ruralguru/ClockRadio_6x18SegDisp_I2C/Documents/Block_Diagram/ClockRadio_6x18SegDisp_I2C_Block_Diagram.pdf

# Clock Radio Display Board

# Block Diagram

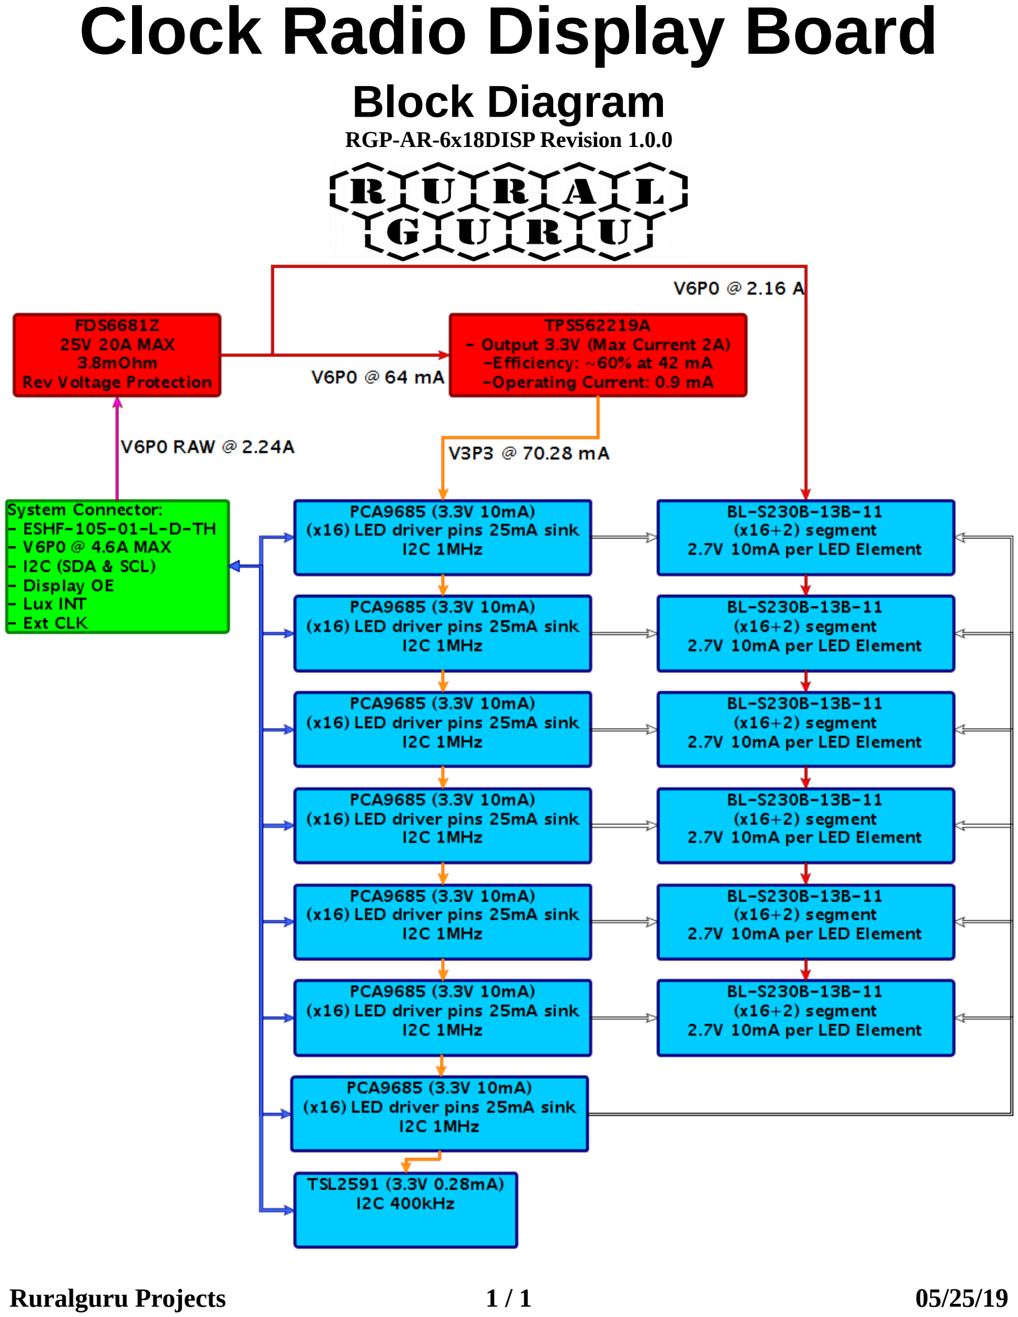
[picture p1: page 1]

RGP-AR-6x18DISP Revision 1.0.0

Ruralguru Projects | 1 / 1 | 05/25/19
