ruralguru/ClockRadio_6x18SegDisp_I2C/Documents/Block_Diagram/ClockRadio_6x18SegDisp_I2C_Block_Diagram.jpg

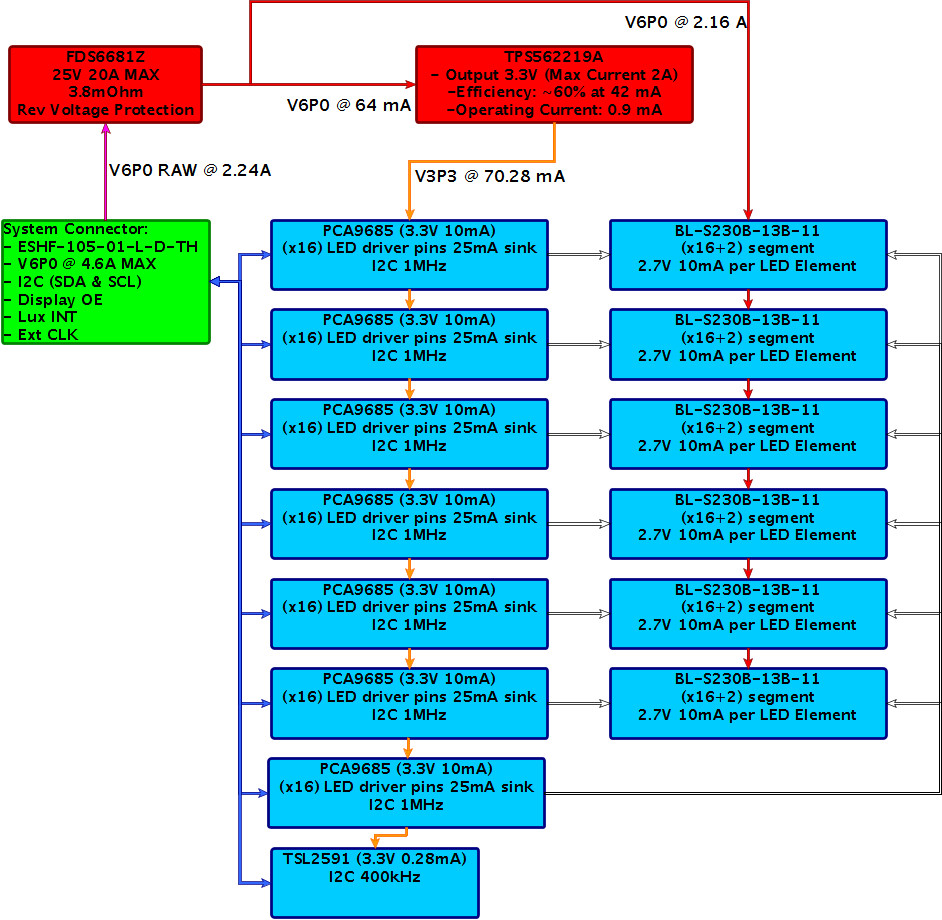
Documents/Block_Diagram/ClockRadio_6x18SegDisp_I2C_Block_Diagram.jpg
