ruralguru/ClockRadio_6x18SegDisp_I2C/Documents/BOM/ClockRadio_Populated.ods

ClockRadio_6x18SegDisp_I2C BOM |  |  |  |  | 05/25/19
Reference | Component | Manufacturer | Description | Total | Used | Cost Per | Total
C101 | EEU-FC1V681 | Panasonic | CAP Dielectric Radial 680uF 5mm Pitch (https://www.mouser.com/ProductDetail/Panasonic/EEU-FC1V681) | 1 | 1 | $0.790 | $0.79
C102 C107 | C1608X5R1A226M080AC | TDK | CAP Ceramic 0603 22uF X5R 10V (https://www.mouser.com/ProductDetail/810-C1608X5R1A226M) | 2 | 2 | $0.480 | $0.96
C103 | GRM033R71A822KA01D | muRata | CAP Ceramic 0603 8.2nF X7R 10V (https://www.mouser.com/ProductDetail/81-GRM033R71A822KA1D) | 1 | 1 | $0.100 | $0.10
C104 C105 C202 C302 C402 C502 C602 C702 C802 | GCM188R91E104KA37D | muRata | CAP Ceramic 0603 0.1uF X7R 25V (https://www.mouser.com/ProductDetail/Murata-Electronics/GCM188R91E104KA37D) | 9 | 9 | $0.149 | $1.34
C106 C201 C301 C401 C501 C601 C701 C801 | GCJ188R71E105KA01D | muRata | CAP Ceramic 0603 1uF X7R 25V (https://www.mouser.com/ProductDetail/Murata-Electronics/GCJ188R71E105KA01D) | 8 | 8 | $0.213 | $1.70
C303 C403 C503 C603 C703 C803 | 860080473006 | Wurth Electronics | CAP Dielectric Radial 100uF 2.5mm Pitch (https://www.mouser.com/ProductDetail/710-860080473006) | 6 | 6 | $0.165 | $0.99
D101 D102 | 150060VS55040 | Wurth Electronics | LED 0603 GRN 2V 20mA (https://www.mouser.com/ProductDetail/710-150060VS55040) | 2 | 2 | $0.170 | $0.34
J101 | ESHF-105-01-L-D-TH | Samtec | CONN 2x5 Header Keyed 2.3A per Pin (https://www.mouser.com/ProductDetail/200-ESHF10501LDTH) | 1 | 1 | $2.810 | $2.81
J102 | PJ-102AH | CUI | CONN Barrell Jack 24V 5A (https://www.mouser.com/ProductDetail/490-PJ-102AH) | 1 | 1 | $0.760 | $0.76
J103 | 10129381-906001BLF | Amphenol | CONN 2x3 Header (https://www.mouser.com/ProductDetail/Amphenol-FCI/10129381-906001BLF) | 1 | 1 | $0.270 | $0.27
L101 | SRP5030T-3R3M | Bourns | IND Fixed 5030 3.3uH 5A 38mOhm (https://www.mouser.com/ProductDetail/652-SRP5030T-3R3M) | 1 | 1 | $1.290 | $1.29
Q101 | FDS6681Z | ON | FET Enhanced P 25V 20A 3.8mOhm (https://www.mouser.com/ProductDetail/512-FDS6681Z) | 1 | 1 | $1.800 | $1.80
R102 R103 R201 R202 R203 R204 R205 R206 R208 R209 R210 R211 R212 R213 R302 R303 R304 R305 R306 R308 R309 R310 R311 R312 R313 R402 R403 R404 R405 R406 R408 R409 R410 R411 R412 R413 R502 R503 R504 R505 R506 R508 R509 R510 R511 R512 R513 R602 R603 R604 R605 R606 R608 R609 R610 R611 R612 R613 R702 R703 R704 R705 R706 R708 R709 R710 R711 R712 R713 R802 R803 R804 R805 R806 R808 R809 R810 R811 R812 R813 | RT0603FRE071KL | Yageo | RES Thin Film 0603 1K 1% (https://www.mouser.com/ProductDetail/603-RT0603FRE071KL) | 80 | 41 | $0.015 | $0.62
R105 | RT0603DRE07200RL | Yageo | RES Thin Film 0603 200R 0.5% (https://www.mouser.com/ProductDetail/Yageo/RT0603DRE07200RL) | 1 | 1 | $0.130 | $0.13
R107 | RT0603FRE07100KL | Yageo | RES Thin Film 0603 100K 1% (https://www.mouser.com/ProductDetail/Yageo/RT0603FRE07100KL?qs=sGAEpiMZZMu61qfTUdNhGxEjuuBLd0B4sFR4hIrpyzw%3D) | 1 | 1 | $0.015 | $0.02
R108 | RT0603DRE0733K2L | Yageo | RES Thin Film 0603 33.2K 0.5% (https://www.mouser.com/ProductDetail/Yageo/RT0603DRE0733K2L) | 1 | 1 | $0.110 | $0.11
R101 R104 R109 R207 R307 R407 R507 R607 R707 R807 | RT0603FRE0710KL | Yageo | RES Thin Film 0603 10K 1% (https://www.mouser.com/ProductDetail/Yageo/RT0603FRE0710KL) | 10 | 10 | $0.045 | $0.45
R110 | RT0603FRE07120RL | Yageo | Res Thin Film 0603 120R 1% (https://www.mouser.com/ProductDetail/Yageo/RT0603FRE07120RL?qs=sGAEpiMZZMu61qfTUdNhGxEjuuBLd0B46F4Pwi2emk8%3D) | 1 | 1 | $0.190 | $0.19
R106 R111 R112 R113 R114 R115 R116 R117 R118 R119 R120 R121 R122 R123 R124 R125 R126 R127 R128 R129 R130 R131 | RC0603FR-070RL | Yageo | RES Thin Film 0603 0R (https://www.mouser.com/ProductDetail/Yageo/RC0603FR-070RL?qs=sGAEpiMZZMvdGkrng054t8AJgcdMkx7xZdNoPBh6LNc%3D) | 22 | 14 | $0.005 | $0.07
R314 R315 R316 R317 R318 R319 R320 R321 R323 R328 R414 R415 R416 R417 R418 R419 R420 R421 R423 R428 R514 R515 R516 R517 R518 R519 R520 R521 R523 R528 R614 R615 R616 R617 R618 R619 R620 R621 R623 R628 R714 R715 R716 R717 R718 R719 R720 R721 R723 R728 R814 R815 R816 R817 R818 R819 R820 R821 R823 R828 | RT0603FRE0715RL | Yageo | RES Thin Film 0603 15R 0.5% (https://www.mouser.com/ProductDetail/Yageo/RT0603FRE0715RL?qs=sGAEpiMZZMu61qfTUdNhGxEjuuBLd0B4DTiXGr7nsPU%3D) | 60 | 60 | $0.015 | $0.90
R324 R325 R326 R327 R329 R330 R424 R425 R426 R427 R429 R430 R524 R525 R526 R527 R529 R530 R624 R625 R626 R627 R629 R630 R724 R725 R726 R727 R729 R730 R824 R825 R826 R827 R829 R830 | RT0603FRE0727RL | Yageo | RES Thin Film 0603 27R 1% (https://www.mouser.com/ProductDetail/603-RT0603FRE0727RL) | 36 | 36 | $0.046 | $1.66
R322 R331 R422 R431 R522 R531 R622 R631 R722 R731 R822 R831 | RT0603DRE07150RL | Yageo | RES Thin Film 0603 150R 0.5% (https://www.mouser.com/ProductDetail/Yageo/RT0603DRE07150RL) | 12 | 12 | $0.074 | $0.89
U101 | TPS562219ADDFT | TI | REG 4.5-17VIN 0.76-7VOUT 2A 650kHz (https://www.mouser.com/ProductDetail/595-TPS562219ADDFT) | 1 | 1 | $1.500 | $1.50
U102 | TSL25911FN | AMS | SENSE LUX 3V 0.28 mA I2C 400kHz 10pF (https://www.mouser.com/ProductDetail/985-TSL25911FN) | 1 | 1 | $2.190 | $2.19
U201 U301 U401 U501 U601 U701 U801 | PCA9685PW,118 | NXP | IC LED Driver 2.3-5.5V 10 mA I2C 1MHz 5pF (x16) IO: 6V 25mA per pin (https://www.mouser.com/ProductDetail/NXP-Semiconductors/PCA9685PW118?qs=sGAEpiMZZMvKM5ialpXrmnWDpPMxsdrM) | 7 | 7 | $2.260 | $15.82
U302 U402 U502 U602 U702 U802 | BL-S230A-13B-11 | betlux | LED 16+2DP Seg. 2.7V 20mA per LED element (https://shop.evilmadscientist.com/productsmenu/partsmenu/631-alphanum23blue) | 6 | 6 | $9.000 | $54.00
PCB | RGP-AR-6x18DISP | Ruralguru Projects | ClockRadio Display Board Rev 1.0.0 (https://github.com/ruralguru/ClockRadio_6x18SegDisp_I2C) | 5 | 1 | $8.700 | $8.70
Ruralguru Projects |  |  | Board Total: |  |  | $101.84
