ruralguru/ClockRadio_6x18SegDisp_I2C/Documents/BOM/ClockRadio_6x18SegDisp_I2C_BOM.ods

ClockRadio_6x18SegDisp_I2C BOM |  |  |  |  | Rural Guru Projects
Reference | Total | Used | Value | Footprint | Datasheet | Cost Per | Total
C101 | 1 | 1 | 680uF | Capacitor_THT:CP_Radial_D12.5mm_P5.00mm | EEU-FC1V681 (https://www.mouser.com/ProductDetail/Panasonic/EEU-FC1V681) | $0.790 | $0.79
C102 C107 | 2 | 2 | 22uF | Capacitor_SMD:C_0603_1608Metric | C1608X5R1A226M080AC (https://www.mouser.com/ProductDetail/810-C1608X5R1A226M) | $0.480 | $0.96
C103 | 1 | 1 | 8.2nF | Capacitor_SMD:C_0201_0603Metric | GRM033R71A822KA01D (https://www.mouser.com/ProductDetail/81-GRM033R71A822KA1D) | $0.100 | $0.10
C104 C105 C202 C302 C402 C502 C602 C702 C802 | 9 | 9 | 0.1uF | Capacitor_SMD:C_0603_1608Metric | GCM188R91E104KA37D (https://www.mouser.com/ProductDetail/Murata-Electronics/GCM188R91E104KA37D) | $0.149 | $1.34
C106 C201 C301 C401 C501 C601 C701 C801 | 8 | 8 | 1uF | Capacitor_SMD:C_0603_1608Metric | GCJ188R71E105KA01D (https://www.mouser.com/ProductDetail/Murata-Electronics/GCJ188R71E105KA01D) | $0.213 | $1.70
C303 C403 C503 C603 C703 C803 | 6 | 6 | 100uF | Capacitor_THT:CP_Radial_D6.3mm_P2.50mm | 860080473006 (https://www.mouser.com/ProductDetail/710-860080473006) | $0.165 | $0.99
D101 D102 | 2 | 2 | GRN | LED_SMD:LED_0603_1608Metric_Castellated | 150060VS55040 (https://www.mouser.com/ProductDetail/710-150060VS55040) | $0.170 | $0.34
J101 | 1 | 1 | SYSTEM 2x5 | ERW_Conn:ESHF-105-01-L-D | ESHF-105-01-L-D-TH (https://www.mouser.com/ProductDetail/200-ESHF10501LDTH) | $2.810 | $2.81
J102 | 1 | 1 | 5A Jack | ERW_Conn:BarrelJack_CUI_PJ-102AH_Horizontal | PJ-102AH (https://www.mouser.com/ProductDetail/490-PJ-102AH) | $0.760 | $0.76
J103 | 1 | 1 | 2X3 Header | Connector_PinHeader_2.54mm: PinHeader_2x03_P2.54mm_Vertical | 10129381-906001BLF (https://www.mouser.com/ProductDetail/Amphenol-FCI/10129381-906001BLF) | $0.270 | $0.27
L101 | 1 | 1 | 3.3uH | ERW_Inductor:INDC570X520X280 | SRP5030T-3R3M (https://www.mouser.com/ProductDetail/652-SRP5030T-3R3M) | $1.290 | $1.29
Q101 | 1 | 1 | FDS6681Z | ERW_SO:SO-8_5.3x6.2mm_P1.27mm | FDS6681Z (https://www.mouser.com/ProductDetail/512-FDS6681Z) | $1.800 | $1.80
R102 R103 R201 R202 R203 R204 R205 R206 R208 R209 R210 R211 R212 R213 R302 R303 R304 R305 R306 R308 R309 R310 R311 R312 R313 R402 R403 R404 R405 R406 R408 R409 R410 R411 R412 R413 R502 R503 R504 R505 R506 R508 R509 R510 R511 R512 R513 R602 R603 R604 R605 R606 R608 R609 R610 R611 R612 R613 R702 R703 R704 R705 R706 R708 R709 R710 R711 R712 R713 R802 R803 R804 R805 R806 R808 R809 R810 R811 R812 R813 | 80 | 41 | 1k | Resistor_SMD:R_0603_1608Metric | RT0603FRE071KL (https://www.mouser.com/ProductDetail/603-RT0603FRE071KL) | $0.015 | $0.62
R105 | 1 | 1 | 200Ω | Resistor_SMD:R_0603_1608Metric | RT0603DRE07200RL (https://www.mouser.com/ProductDetail/Yageo/RT0603DRE07200RL) | $0.130 | $0.13
R107 | 1 | 1 | 100k | Resistor_SMD:R_0603_1608Metric | RT0603FRE07100KL (https://www.mouser.com/ProductDetail/Yageo/RT0603FRE07100KL?qs=sGAEpiMZZMu61qfTUdNhGxEjuuBLd0B4sFR4hIrpyzw%3D) | $0.015 | $0.02
R108 | 1 | 1 | 33.2k | Resistor_SMD:R_0603_1608Metric | RT0603DRE0733K2L (https://www.mouser.com/ProductDetail/Yageo/RT0603DRE0733K2L) | $0.110 | $0.11
R101 R104 R109 R207 R307 R407 R507 R607 R707 R807 | 10 | 10 | 10k | Resistor_SMD:R_0603_1608Metric | RT0603FRE0710KL (https://www.mouser.com/ProductDetail/Yageo/RT0603FRE0710KL) | $0.045 | $0.45
R110 | 1 | 1 | 120Ω | Resistor_SMD:R_0603_1608Metric | RT0603FRE07120RL (https://www.mouser.com/ProductDetail/Yageo/RT0603FRE07120RL?qs=sGAEpiMZZMu61qfTUdNhGxEjuuBLd0B46F4Pwi2emk8%3D) | $0.190 | $0.19
R106 R111 R112 R113 R114 R115 R116 R117 R118 R119 R120 R121 R122 R123 R124 R125 R126 R127 R128 R129 R130 R131 | 22 | 14 | 0Ω | Resistor_SMD:R_0603_1608Metric | MCT0603MZ0000ZP500 (https://www.mouser.com/ProductDetail/594-MCT0603MZ0000ZP5) | $0.070 | $0.98
R314 R315 R316 R317 R318 R319 R320 R321 R323 R328 R414 R415 R416 R417 R418 R419 R420 R421 R423 R428 R514 R515 R516 R517 R518 R519 R520 R521 R523 R528 R614 R615 R616 R617 R618 R619 R620 R621 R623 R628 R714 R715 R716 R717 R718 R719 R720 R721 R723 R728 R814 R815 R816 R817 R818 R819 R820 R821 R823 R828 | 60 | 60 | 15Ω | Resistor_SMD:R_0603_1608Metric | 603-RT0603DRE0715RL (https://www.mouser.com/ProductDetail/603-RT0603DRE0715RL) | $0.024 | $1.44
R324 R325 R326 R327 R329 R330 R424 R425 R426 R427 R429 R430 R524 R525 R526 R527 R529 R530 R624 R625 R626 R627 R629 R630 R724 R725 R726 R727 R729 R730 R824 R825 R826 R827 R829 R830 | 36 | 36 | 27Ω | Resistor_SMD:R_0603_1608Metric | 603-RT0603FRE0727RL (https://www.mouser.com/ProductDetail/603-RT0603FRE0727RL) | $0.046 | $1.66
R322 R331 R422 R431 R522 R531 R622 R631 R722 R731 R822 R831 | 12 | 12 | 150Ω | Resistor_SMD:R_0603_1608Metric | RT0603DRE07150RL (https://www.mouser.com/ProductDetail/Yageo/RT0603DRE07150RL) | $0.074 | $0.89
U101 | 1 | 1 | TPS562219A | ERW_TO_SOT_SMD:SOT-23-8 | TPS562219ADDFT (https://www.mouser.com/ProductDetail/595-TPS562219ADDFT) | $1.500 | $1.50
U102 | 1 | 1 | TSL2591 | ERW_DFN:DFN240X200X65-6 | TSL25911FN (https://www.mouser.com/ProductDetail/985-TSL25911FN) | $2.190 | $2.19
U201 U301 U401 U501 U601 U701 U801 | 7 | 7 | PCA9685PW | Package_SO:TSSOP-28_4.4x9.7mm_P0.65mm | PCA9685PW,118 (https://www.mouser.com/ProductDetail/NXP-Semiconductors/PCA9685PW118?qs=sGAEpiMZZMvKM5ialpXrmnWDpPMxsdrM) | $2.260 | $15.82
U302 U402 U502 U602 U702 U802 | 6 | 6 | BL-S230B | ERW_LED:BL-230X-13 | BL-S230A-13B-11 (https://shop.evilmadscientist.com/productsmenu/partsmenu/631-alphanum23blue) | $9.000 | $54.00
PCB | 5 | 1 | RGP-AR-6x18DISP | ClockRadio_6x18SegDisp_I2C.kicad_pcb (Fabricated by JCLPCB) | ClockRadio_6x18SegDisp_I2C (https://github.com/ruralguru/ClockRadio_6x18SegDisp_I2C) | $8.700 | $8.70
 |  |  |  | 05/25/19 | Board Total Cost: | $101.84
