ruralguru/ClockRadio_6x18SegDisp_I2C/Documents/ClockRadio_6x18SegDisp_I2C.pdf

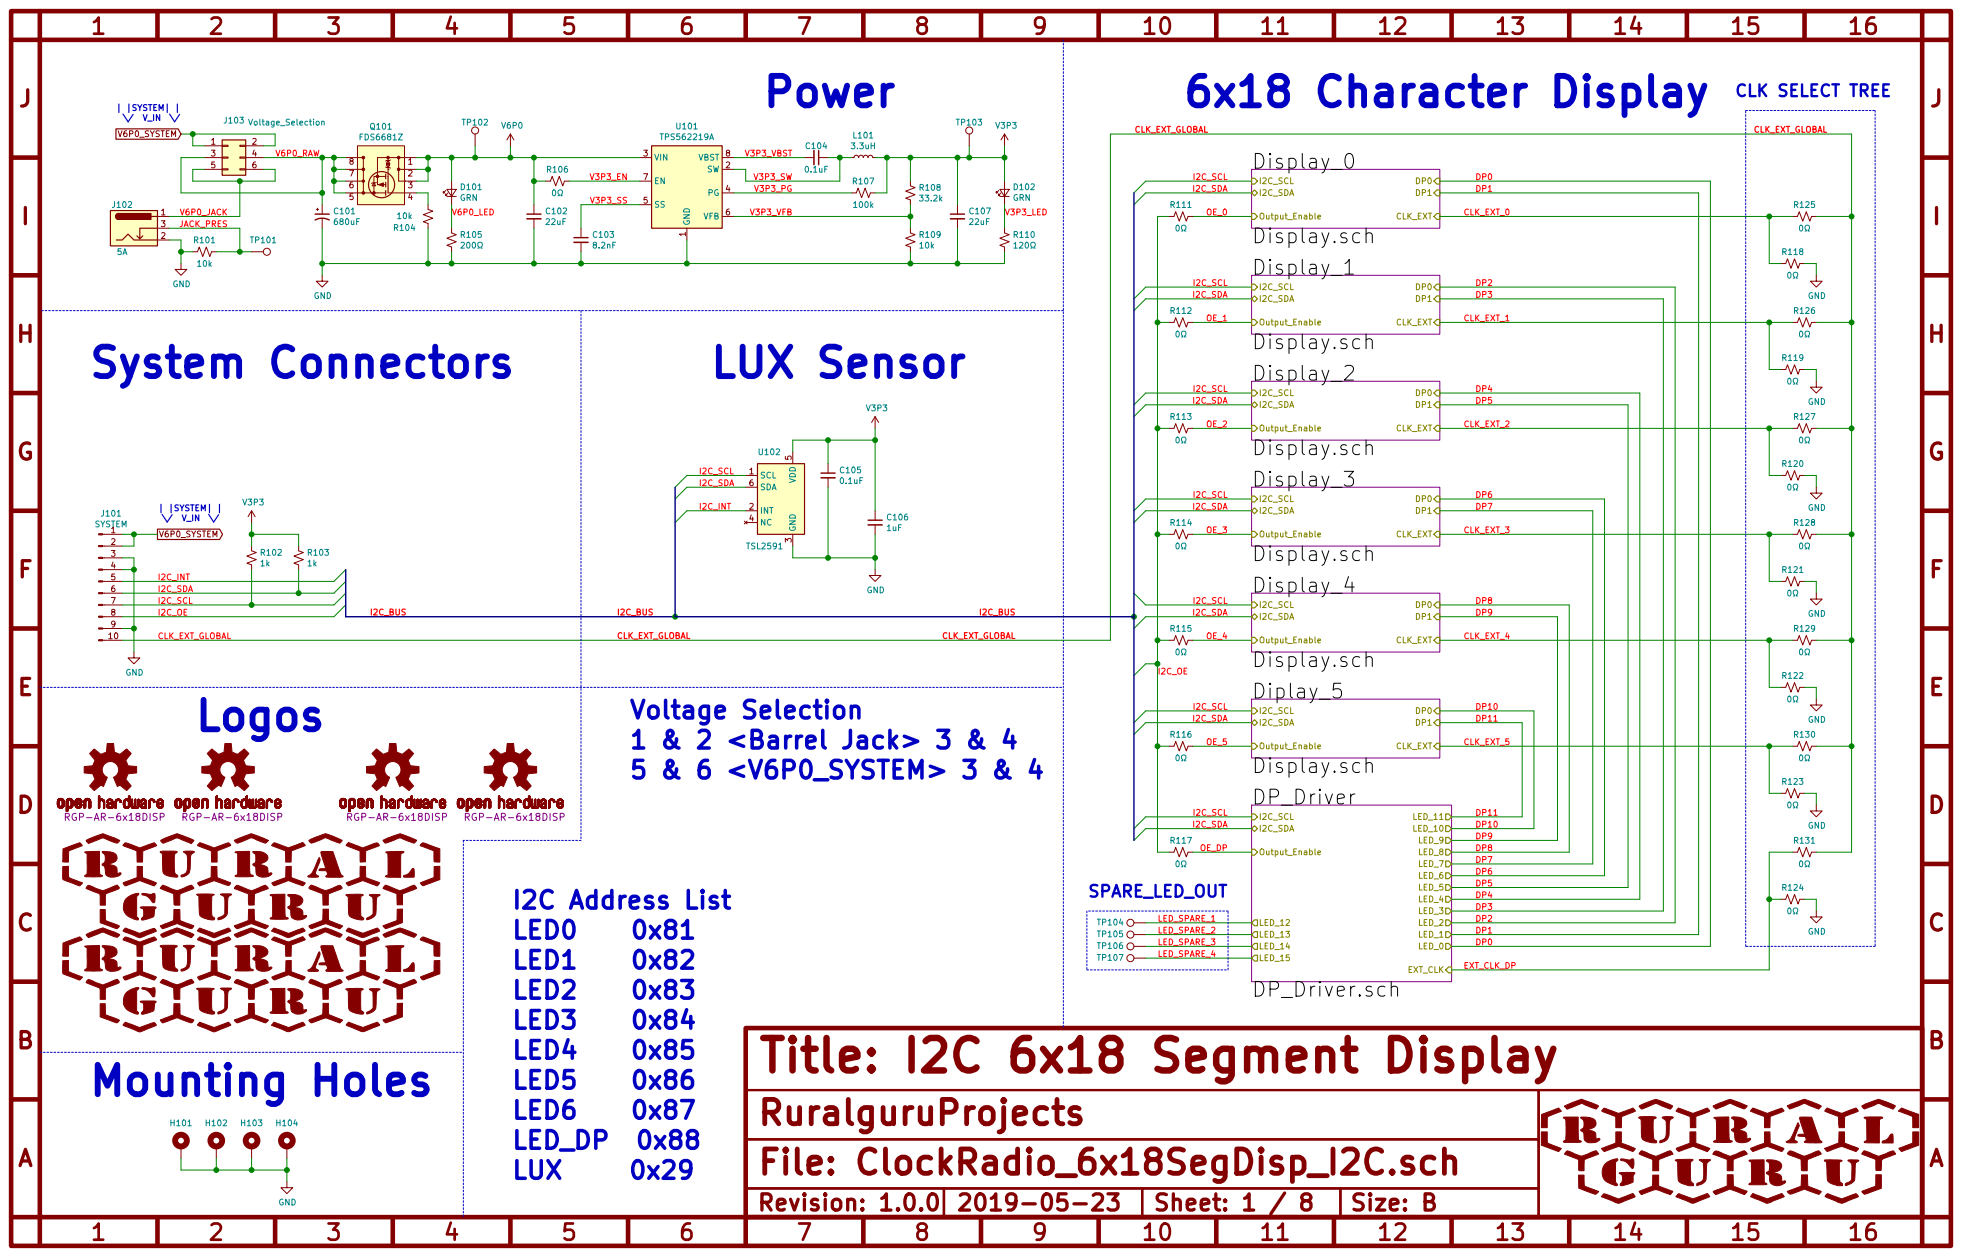
[picture p3: page 1]

1 SW 2 VIN 3 PG 4 SS 5 VFB 6 EN 7 VBST 8 U101 TPS562219A C103
5A Mounting Holes

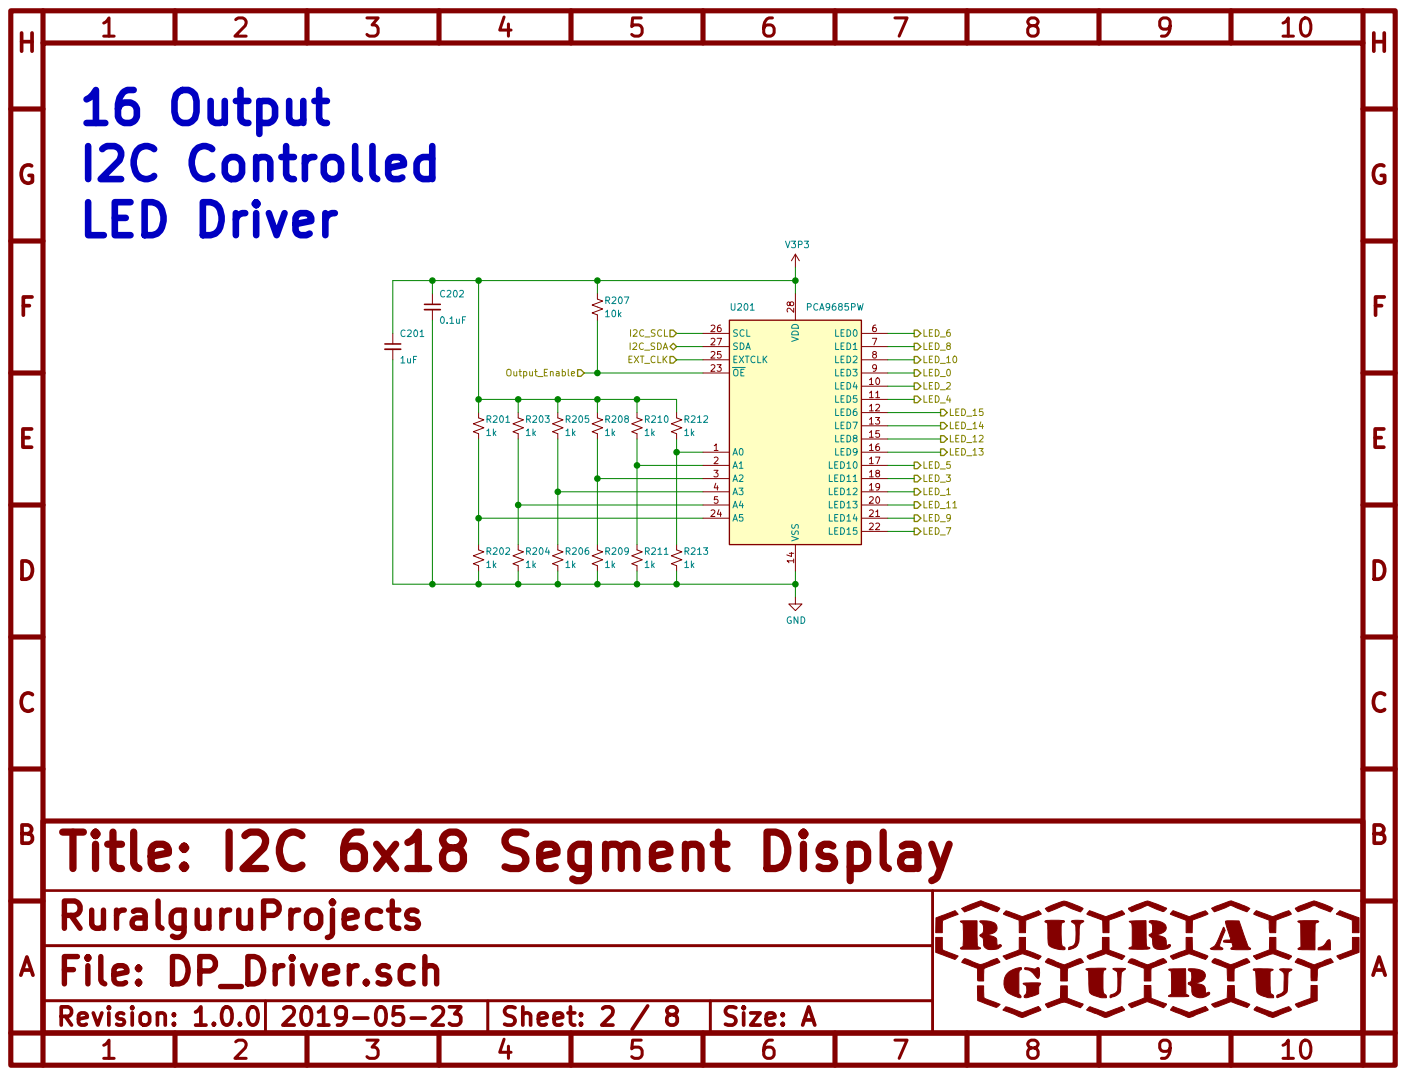
[picture p4: page 2]

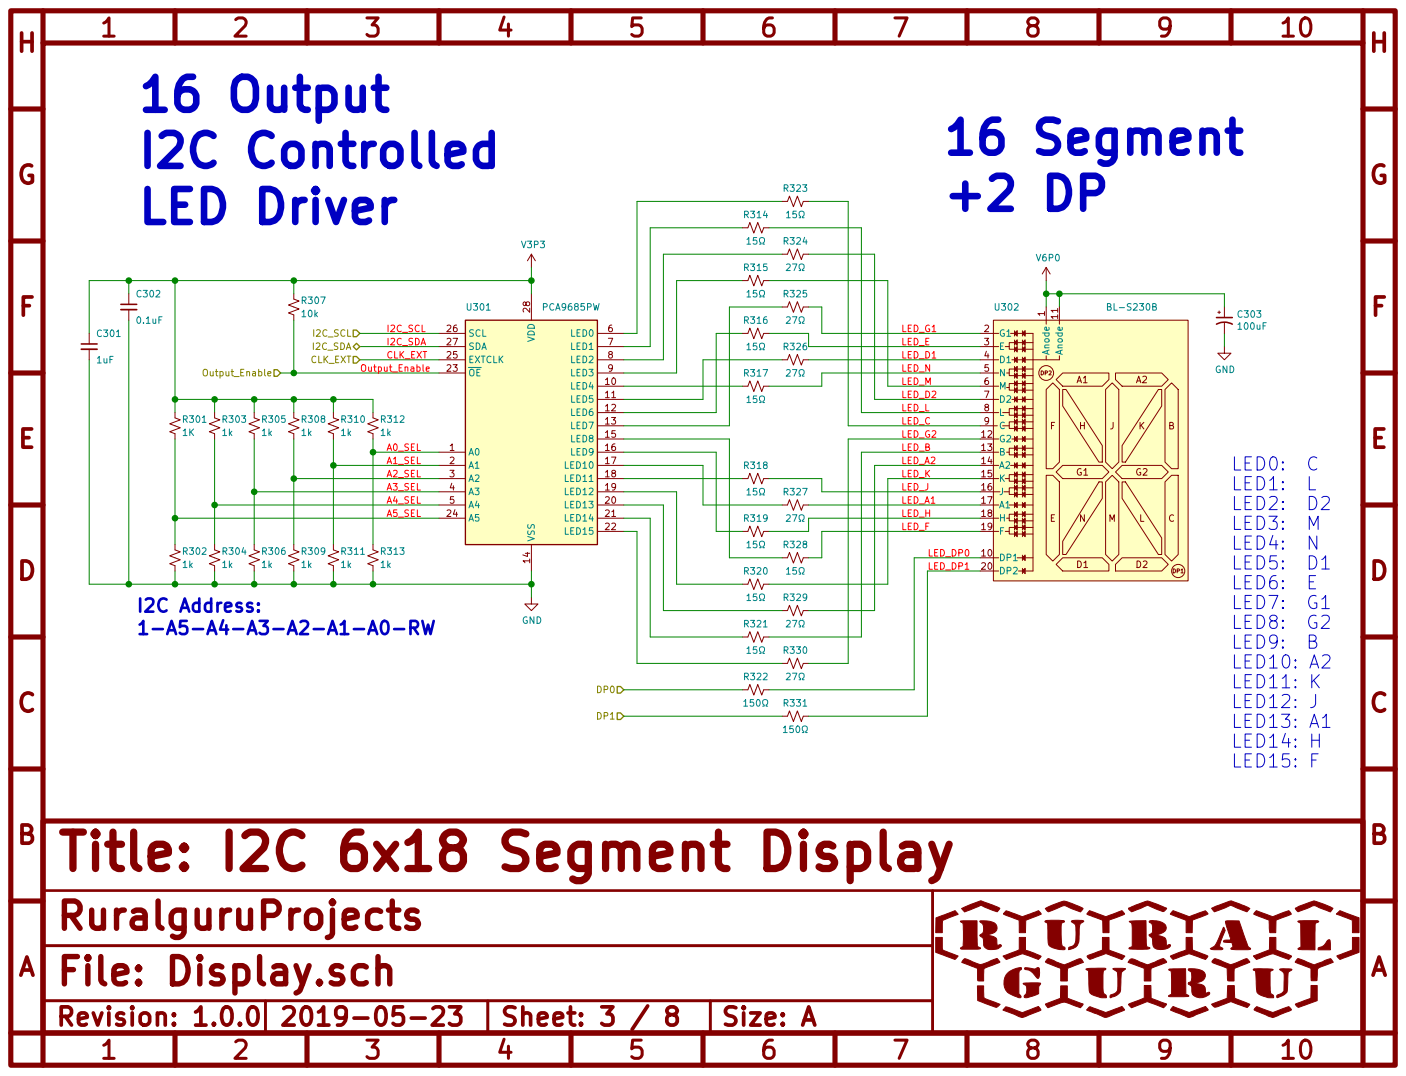
[picture p5: page 3]

LED_F

LED_DP0

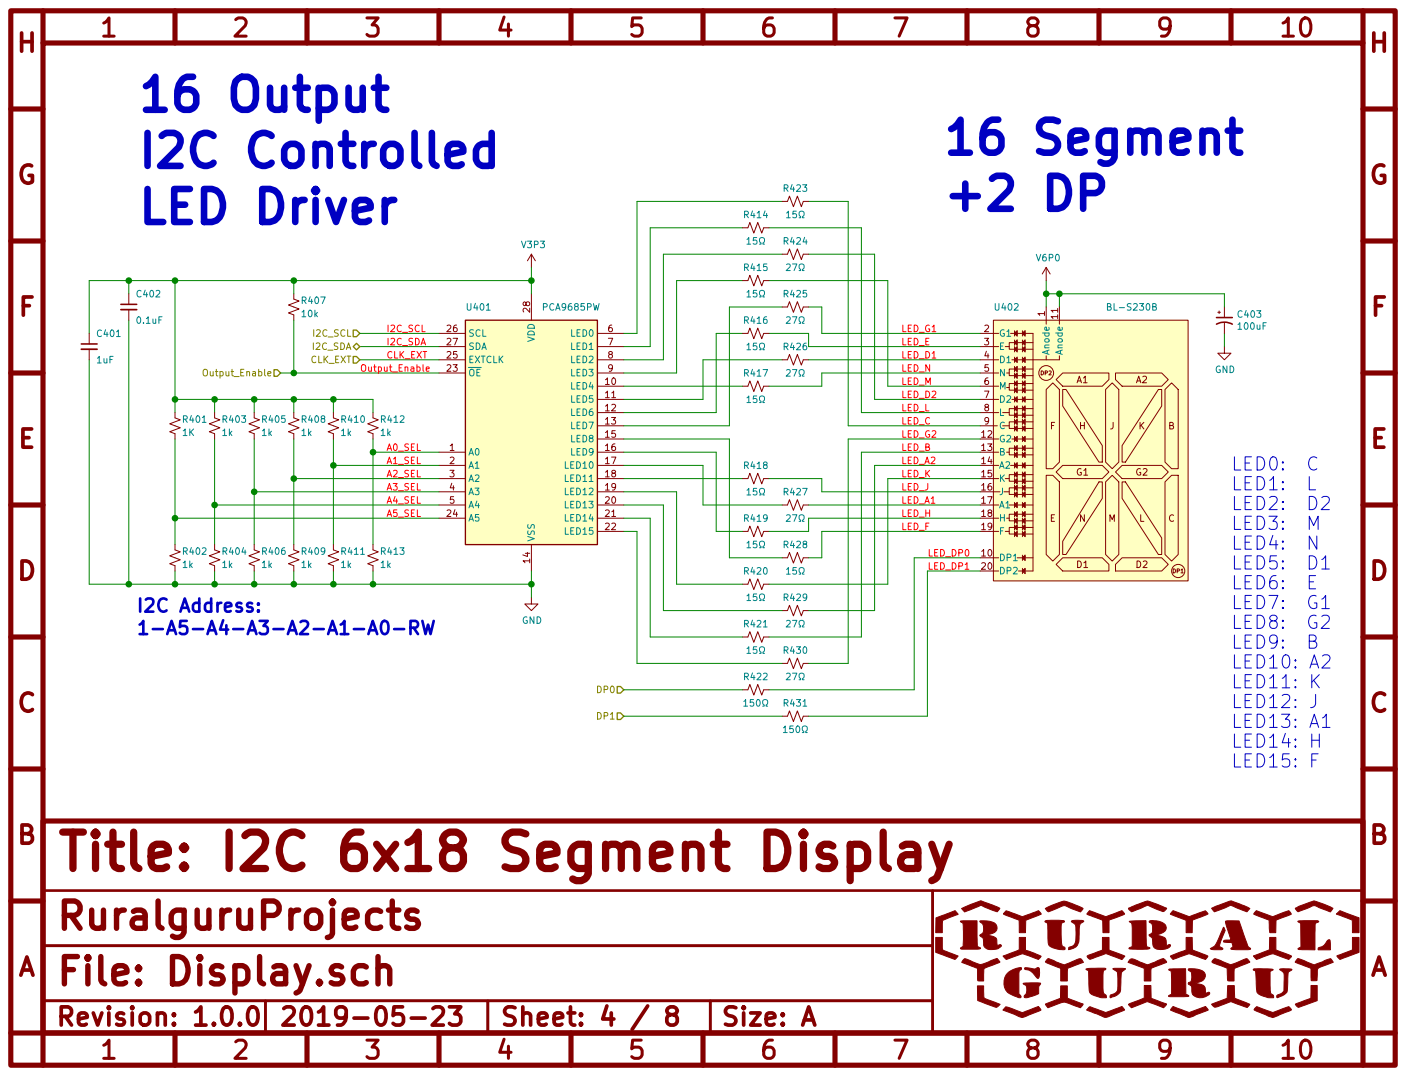
[picture p6: page 4]

LED_F

LED_DP0

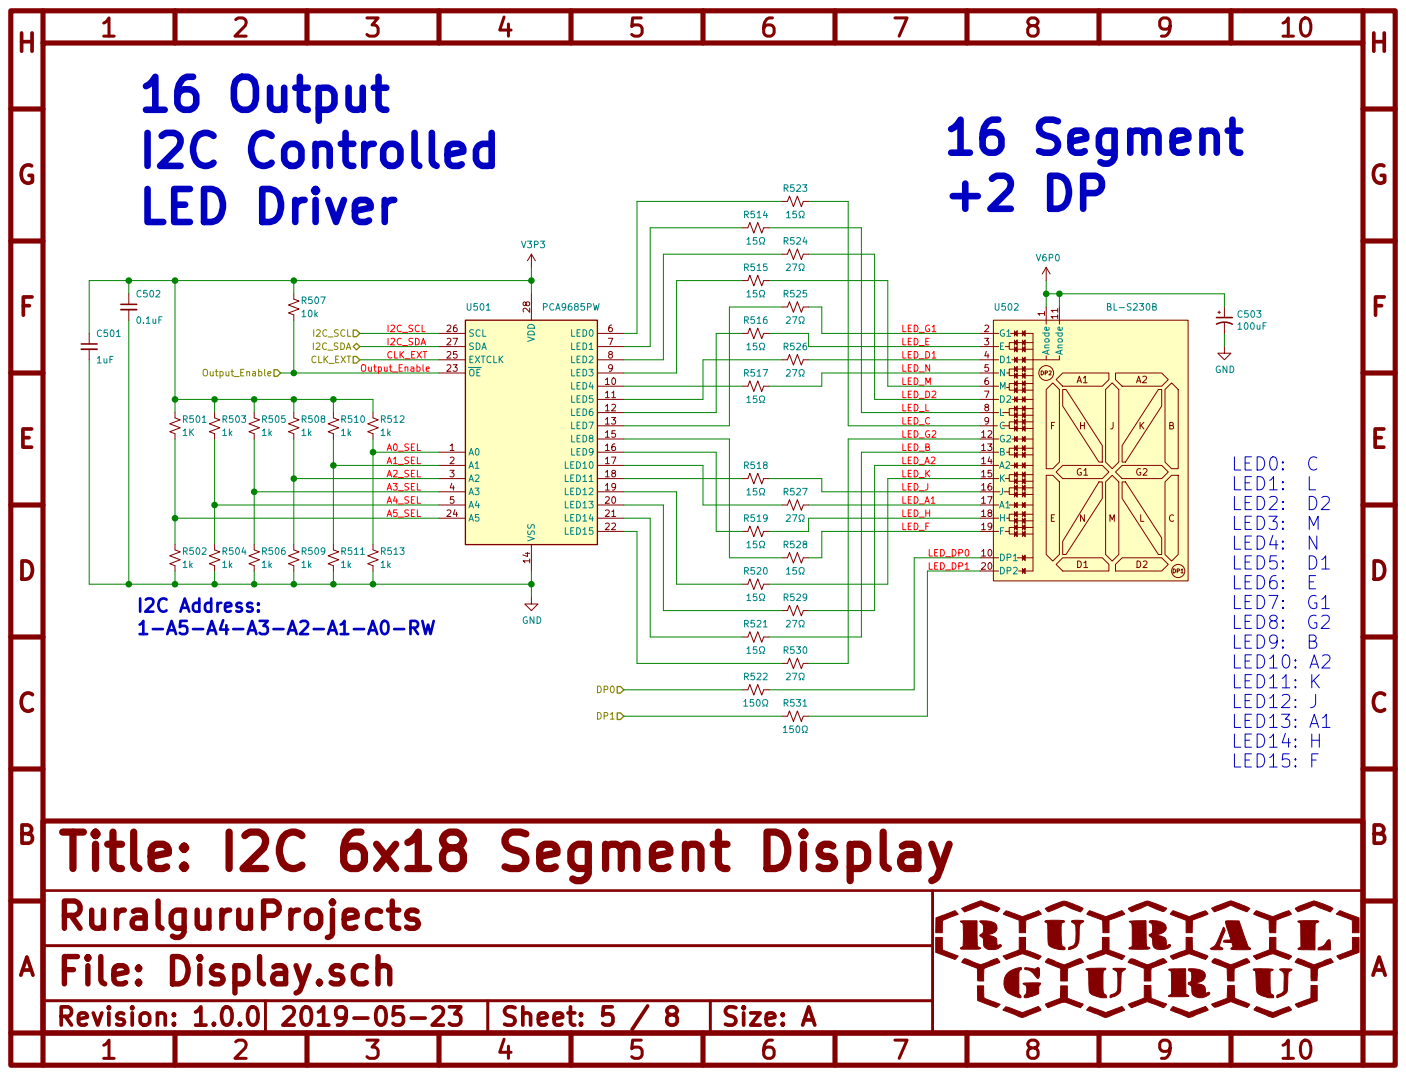
[picture p7: page 5]

LED_F

LED_DP0

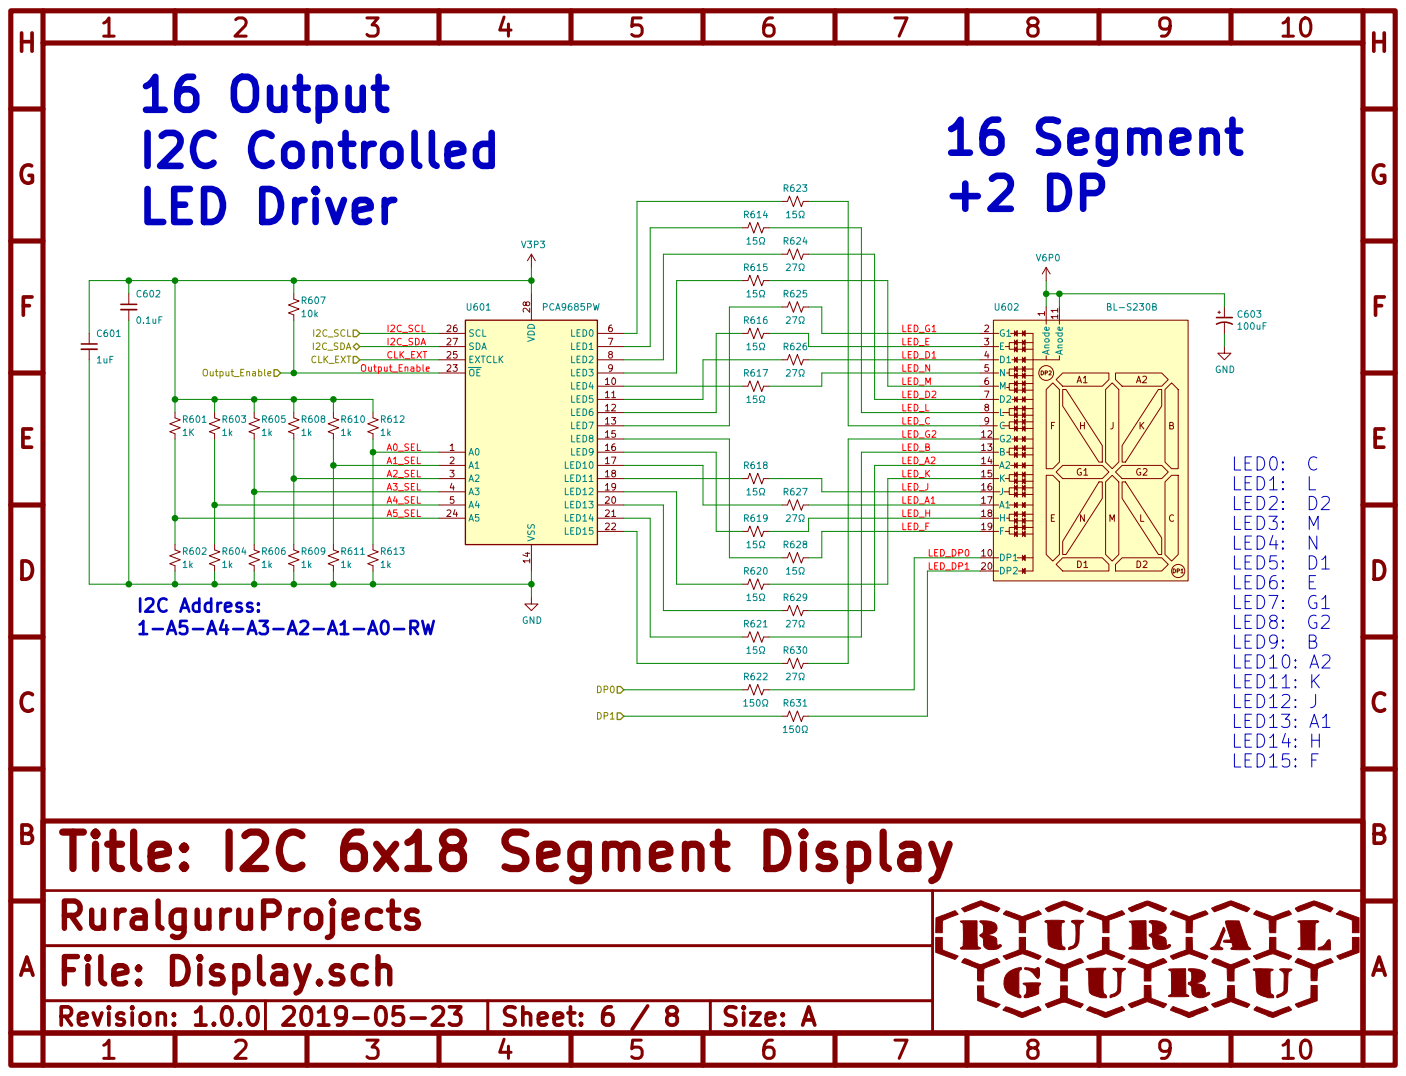
[picture p8: page 6]

LED_F

LED_DP0

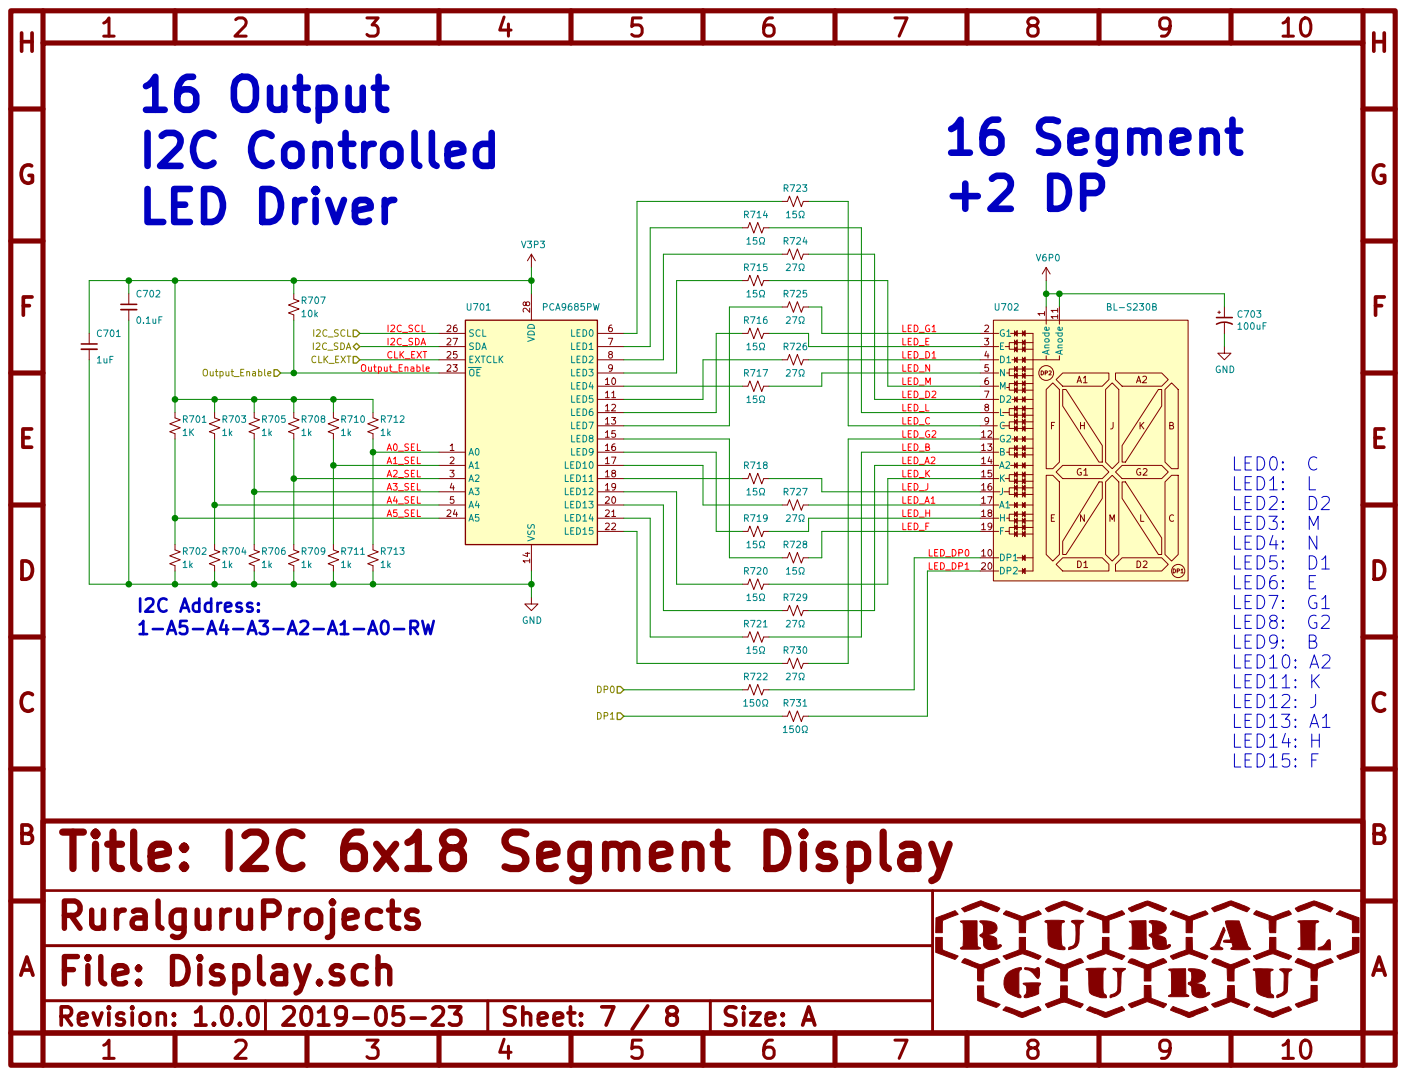
[picture p9: page 7]

LED_F

LED_DP0

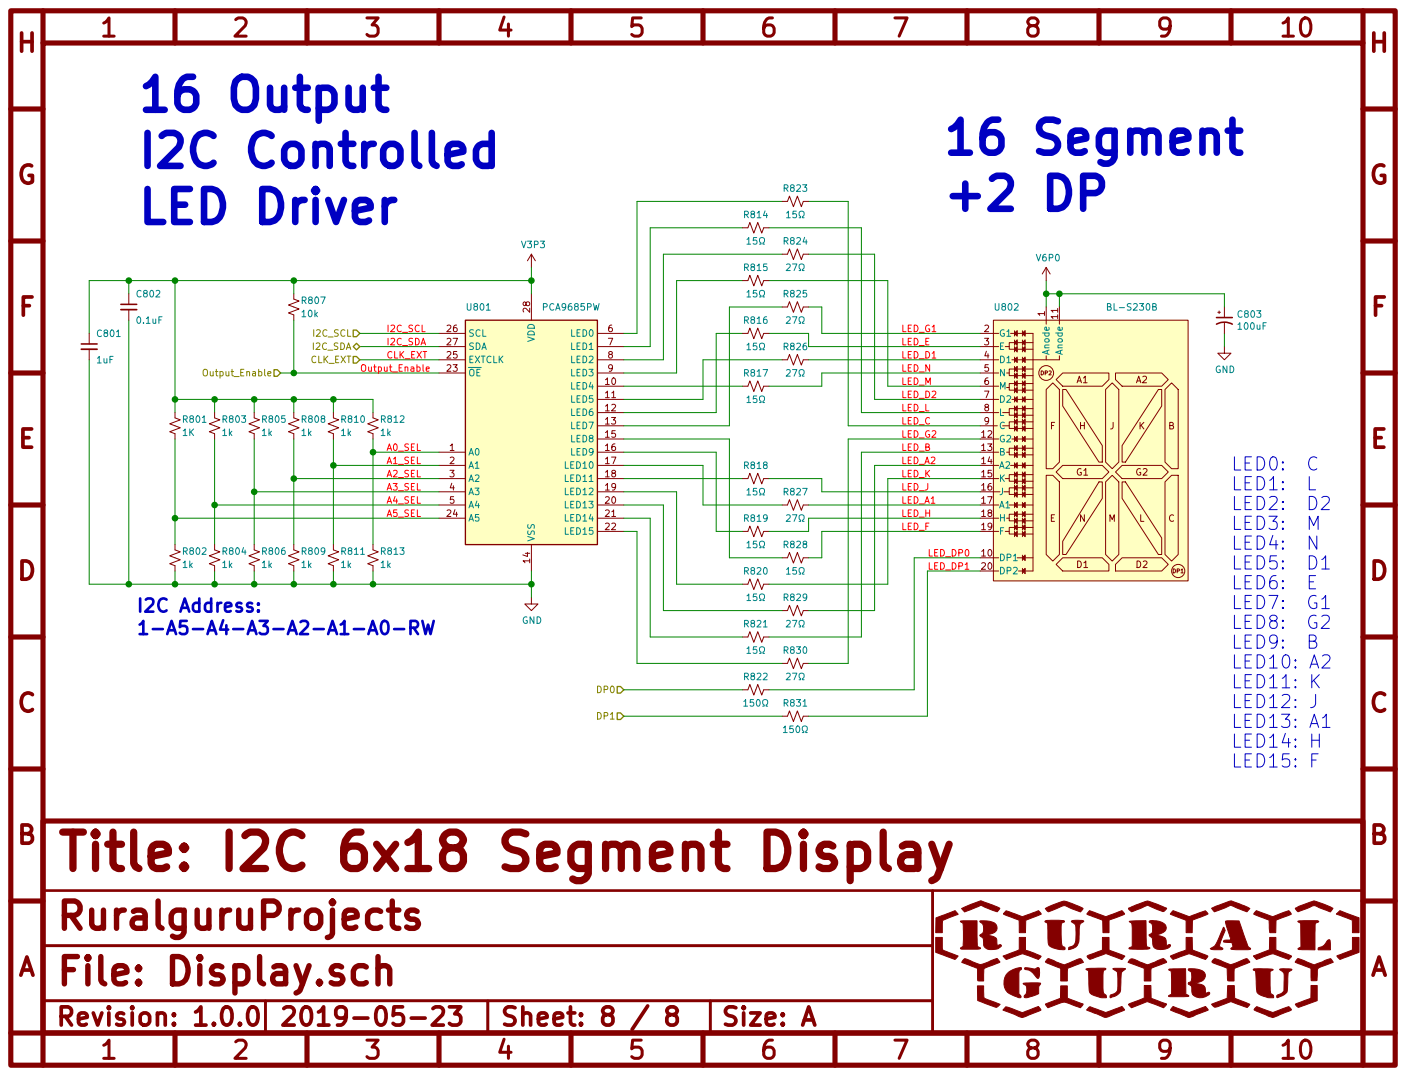
[picture p10: page 8]

LED_F

LED_DP0
