ruralguru/ClockRadio_6x18SegDisp_I2C/ClockRadio_6x18SegDisp_I2C.kicad_pcb

## KiCad design ClockRadio_6x18SegDisp_I2C.kicad_pcb (2019-07-02)

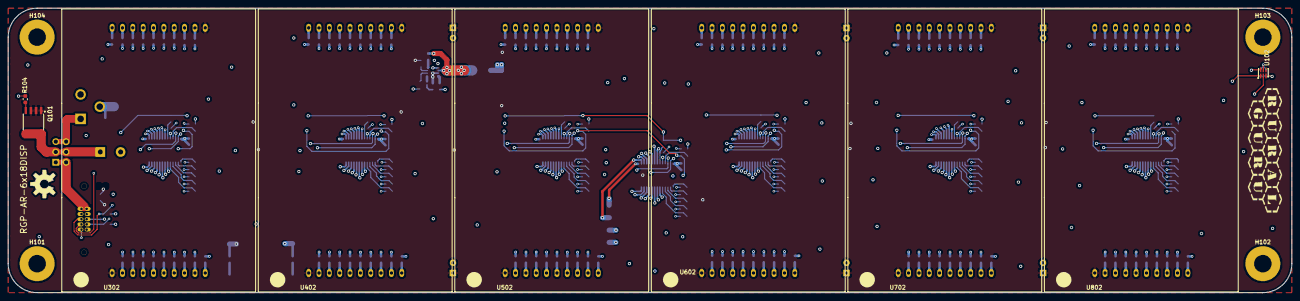
[picture p11: board ClockRadio_6x18SegDisp_I2C.kicad_pcb from above]

Board: 4 copper layers, 315.2 x 69.9 mm, 297 parts (0 on the bottom side), 297 nets.

Parts:
C101: 680uF; CP_Radial_D12.5mm_P5.00mm
C102, C107: 22uF; C_0603_1608Metric
C103: 8.2nF; C_0201_0603Metric
C104, C105, C202, C302, C402, C502, C602, C702, C802: 0.1uF; C_0603_1608Metric
C106, C201, C301, C401, C501, C601, C701, C801: 1uF; C_0603_1608Metric
C303, C403, C503, C603, C703, C803: 100uF; CP_Radial_D6.3mm_P2.50mm
D101, D102: GRN; LED_0603_1608Metric_Castellated
G101, G102: RGP-AR-6x18DISP; OSHW-LOGO-L
G103, G104: LOGO; RuralguruProjects_HEX
G105, G106: RGP-AR-6x18DISP; OSHW-LOGO-L_COPPER
H101, H102, H103, H104: MountingHole_Pad; MountingHole_4.3mm_M4_Pad
J101: Display_tether; ESHF-105-01-L-D
J102: 5A; BarrelJack_CUI_PJ-102AH_Horizontal
J103: Voltage_Selection; PinHeader_2x03_P2.54mm_Vertical
L101: 3.3uH; INDC570X520X280
Q101: FDS6681Z; SO-8_5.3x6.2mm_P1.27mm
R101, R109, R207, R307, R407, R507, R607, R707, R807: 10k; R_0603_1608Metric
R102, R103, R104, R201, R202, R203, R204, R205, R206, R208, R209, R210, R211, R212, R213, R302, R303, R304, R305, R306, R308, R309, R310, R311, R312, R313, R402, R403, R404, R405, R406, R408, R409, R410, R411, R412, R413, R502, R503, R504, R505, R506, R508, R509, R510, R511, R512, R513, R602, R603, R604, R605, R606, R608, R609, R610, R611, R612, R613, R702, R703, R704, R705, R706, R708, R709, R710, R711, R712, R713, R802, R803, R804, R805, R806, R808, R809, R810, R811, R812, R813, R1001: 1k; R_0603_1608Metric
R105: 200Ω; R_0603_1608Metric
R106, R111, R112, R113, R114, R115, R116, R117, R118, R119, R120, R121, R122, R123, R124, R125, R126, R127, R128, R129, R130, R131: 0Ω; R_0603_1608Metric
R107: 100k; R_0603_1608Metric
R108: 33.2k; R_0603_1608Metric
R110: 120Ω; R_0603_1608Metric
R301, R401, R501, R601, R701, R801: 1K; R_0603_1608Metric
R314, R315, R316, R317, R318, R319, R320, R321, R323, R328, R414, R415, R416, R417, R418, R419, R420, R421, R423, R428, R514, R515, R516, R517, R518, R519, R520, R521, R523, R528, R614, R615, R616, R617, R618, R619, R620, R621, R623, R628, R714, R715, R716, R717, R718, R719, R720, R721, R723, R728, R814, R815, R816, R817, R818, R819, R820, R821, R823, R828: 15Ω; R_0603_1608Metric
R322, R331, R422, R431, R522, R531, R622, R631, R722, R731, R822, R831: 150Ω; R_0603_1608Metric
R324, R325, R326, R327, R329, R330, R424, R425, R426, R427, R429, R430, R524, R525, R526, R527, R529, R530, R624, R625, R626, R627, R629, R630, R724, R725, R726, R727, R729, R730, R824, R825, R826, R827, R829, R830: 27Ω; R_0603_1608Metric
TP101, TP102, TP103, TP104, TP105, TP106, TP107: TestPoint; TestPoint_Pad_D2.0mm
U101: TPS562219A; SOT-23-8
U102: TSL2591; DFN240X200X65-6
U201, U301, U401, U501, U601, U701, U801: PCA9685PW; TSSOP-28_4.4x9.7mm_P0.65mm
U302, U402, U502, U602, U702, U802: BL-S230B; BL-230X-13

Connections:
/CLK_EXT_0: R118.2, R125.2, U301.25
/CLK_EXT_1: R119.2, R126.2, U401.25
/CLK_EXT_2: R120.2, R127.2, U501.25
/CLK_EXT_3: R121.2, R128.2, U601.25
/CLK_EXT_4: R122.2, R129.2, U701.25
/CLK_EXT_5: R123.2, R130.2, U801.25
/CLK_EXT_GLOBAL: J101.10, R125.1, R126.1, R127.1, R128.1, R129.1, R130.1, R131.1
/DP0: R322.2, U201.9
/DP1: R331.2, U201.19
/DP2: R422.2, U201.10
/DP3: R431.2, U201.18
/DP4: R522.2, U201.11
/DP5: R531.2, U201.17
/DP6: R622.2, U201.6
/DP7: R631.2, U201.22
/DP8: R722.2, U201.7
/DP9: R731.2, U201.21
/DP10: R822.2, U201.8
/DP11: R831.2, U201.20
/Diplay_5/A0_SEL: R812.2, R813.1, U801.1
/Diplay_5/A1_SEL: R810.2, R811.1, U801.2
/Diplay_5/A2_SEL: R808.2, R809.1, U801.3
/Diplay_5/A3_SEL: R805.2, R806.1, U801.4
/Diplay_5/A4_SEL: R803.2, R804.1, U801.5
/Diplay_5/A5_SEL: R801.2, R802.1, U801.24
/Diplay_5/LED0: R823.2, U801.6
/Diplay_5/LED1: R814.2, U801.7
/Diplay_5/LED2: R824.2, U801.8
/Diplay_5/LED3: R815.2, U801.9
/Diplay_5/LED4: R817.2, U801.10
/Diplay_5/LED5: R826.2, U801.11
/Diplay_5/LED6: R816.2, U801.12
/Diplay_5/LED7: R825.2, U801.13
/Diplay_5/LED8: R828.2, U801.15
/Diplay_5/LED9: R819.2, U801.16
/Diplay_5/LED10: R827.2, U801.17
/Diplay_5/LED11: R818.2, U801.18
/Diplay_5/LED12: R820.2, U801.19
/Diplay_5/LED13: R829.2, U801.20
/Diplay_5/LED14: R821.2, U801.21
/Diplay_5/LED15: R830.2, U801.22
/Diplay_5/LED_A1: R827.1, U802.17
/Diplay_5/LED_A2: R829.1, U802.14
/Diplay_5/LED_B: R821.1, U802.13
/Diplay_5/LED_C: R823.1, U802.9
/Diplay_5/LED_D1: R826.1, U802.4
/Diplay_5/LED_D2: R824.1, U802.7
/Diplay_5/LED_DP0: R822.1, U802.10
/Diplay_5/LED_DP1: R831.1, U802.20
/Diplay_5/LED_E: R816.1, U802.3
/Diplay_5/LED_F: R828.1, U802.19
/Diplay_5/LED_G1: R825.1, U802.2
/Diplay_5/LED_G2: R830.1, U802.12
/Diplay_5/LED_H: R819.1, U802.18
/Diplay_5/LED_J: R818.1, U802.16
/Diplay_5/LED_K: R820.1, U802.15
/Diplay_5/LED_L: R814.1, U802.8
/Diplay_5/LED_M: R815.1, U802.6
/Diplay_5/LED_N: R817.1, U802.5
/Display_0/A0_SEL: R312.2, R313.1, U301.1
/Display_0/A1_SEL: R310.2, R311.1, U301.2
/Display_0/A2_SEL: R308.2, R309.1, U301.3
/Display_0/A3_SEL: R305.2, R306.1, U301.4
/Display_0/A4_SEL: R303.2, R304.1, U301.5
/Display_0/A5_SEL: R301.2, R302.1, U301.24
/Display_0/LED0: R323.2, U301.6
/Display_0/LED1: R314.2, U301.7
/Display_0/LED2: R324.2, U301.8
/Display_0/LED3: R315.2, U301.9
/Display_0/LED4: R317.2, U301.10
/Display_0/LED5: R326.2, U301.11
/Display_0/LED6: R316.2, U301.12
/Display_0/LED7: R325.2, U301.13
/Display_0/LED8: R328.2, U301.15
/Display_0/LED9: R319.2, U301.16
/Display_0/LED10: R327.2, U301.17
/Display_0/LED11: R318.2, U301.18
/Display_0/LED12: R320.2, U301.19
/Display_0/LED13: R329.2, U301.20
/Display_0/LED14: R321.2, U301.21
/Display_0/LED15: R330.2, U301.22
/Display_0/LED_A1: R327.1, U302.17
/Display_0/LED_A2: R329.1, U302.14
/Display_0/LED_B: R321.1, U302.13
/Display_0/LED_C: R323.1, U302.9
/Display_0/LED_D1: R326.1, U302.4
/Display_0/LED_D2: R324.1, U302.7
/Display_0/LED_DP0: R322.1, U302.10
/Display_0/LED_DP1: R331.1, U302.20
/Display_0/LED_E: R316.1, U302.3
/Display_0/LED_F: R328.1, U302.19
/Display_0/LED_G1: R325.1, U302.2
/Display_0/LED_G2: R330.1, U302.12
/Display_0/LED_H: R319.1, U302.18
/Display_0/LED_J: R318.1, U302.16
/Display_0/LED_K: R320.1, U302.15
/Display_0/LED_L: R314.1, U302.8
/Display_0/LED_M: R315.1, U302.6
/Display_0/LED_N: R317.1, U302.5
/Display_1/A0_SEL: R412.2, R413.1, U401.1
/Display_1/A1_SEL: R410.2, R411.1, U401.2
/Display_1/A2_SEL: R408.2, R409.1, U401.3
/Display_1/A3_SEL: R405.2, R406.1, U401.4
/Display_1/A4_SEL: R403.2, R404.1, U401.5
/Display_1/A5_SEL: R401.2, R402.1, U401.24
/Display_1/LED0: R423.2, U401.6
/Display_1/LED1: R414.2, U401.7
/Display_1/LED2: R424.2, U401.8
/Display_1/LED3: R415.2, U401.9
/Display_1/LED4: R417.2, U401.10
/Display_1/LED5: R426.2, U401.11
/Display_1/LED6: R416.2, U401.12
/Display_1/LED7: R425.2, U401.13
/Display_1/LED8: R428.2, U401.15
/Display_1/LED9: R419.2, U401.16
/Display_1/LED10: R427.2, U401.17
/Display_1/LED11: R418.2, U401.18
/Display_1/LED12: R420.2, U401.19
/Display_1/LED13: R429.2, U401.20
/Display_1/LED14: R421.2, U401.21
/Display_1/LED15: R430.2, U401.22
/Display_1/LED_A1: R427.1, U402.17
/Display_1/LED_A2: R429.1, U402.14
/Display_1/LED_B: R421.1, U402.13
/Display_1/LED_C: R423.1, U402.9
/Display_1/LED_D1: R426.1, U402.4
/Display_1/LED_D2: R424.1, U402.7
/Display_1/LED_DP0: R422.1, U402.10
/Display_1/LED_DP1: R431.1, U402.20
/Display_1/LED_E: R416.1, U402.3
/Display_1/LED_F: R428.1, U402.19
/Display_1/LED_G1: R425.1, U402.2
/Display_1/LED_G2: R430.1, U402.12
/Display_1/LED_H: R419.1, U402.18
/Display_1/LED_J: R418.1, U402.16
/Display_1/LED_K: R420.1, U402.15
/Display_1/LED_L: R414.1, U402.8
/Display_1/LED_M: R415.1, U402.6
/Display_1/LED_N: R417.1, U402.5
/Display_2/A0_SEL: R512.2, R513.1, U501.1
/Display_2/A1_SEL: R510.2, R511.1, U501.2
/Display_2/A2_SEL: R508.2, R509.1, U501.3
/Display_2/A3_SEL: R505.2, R506.1, U501.4
/Display_2/A4_SEL: R503.2, R504.1, U501.5
/Display_2/A5_SEL: R501.2, R502.1, U501.24
/Display_2/LED0: R523.2, U501.6
/Display_2/LED1: R514.2, U501.7
/Display_2/LED2: R524.2, U501.8
/Display_2/LED3: R515.2, U501.9
/Display_2/LED4: R517.2, U501.10
/Display_2/LED5: R526.2, U501.11
/Display_2/LED6: R516.2, U501.12
/Display_2/LED7: R525.2, U501.13
/Display_2/LED8: R528.2, U501.15
/Display_2/LED9: R519.2, U501.16
/Display_2/LED10: R527.2, U501.17
/Display_2/LED11: R518.2, U501.18
/Display_2/LED12: R520.2, U501.19
/Display_2/LED13: R529.2, U501.20
/Display_2/LED14: R521.2, U501.21
/Display_2/LED15: R530.2, U501.22
/Display_2/LED_A1: R527.1, U502.17
/Display_2/LED_A2: R529.1, U502.14
/Display_2/LED_B: R521.1, U502.13
/Display_2/LED_C: R523.1, U502.9
/Display_2/LED_D1: R526.1, U502.4
/Display_2/LED_D2: R524.1, U502.7
/Display_2/LED_DP0: R522.1, U502.10
/Display_2/LED_DP1: R531.1, U502.20
/Display_2/LED_E: R516.1, U502.3
/Display_2/LED_F: R528.1, U502.19
/Display_2/LED_G1: R525.1, U502.2
/Display_2/LED_G2: R530.1, U502.12
/Display_2/LED_H: R519.1, U502.18
/Display_2/LED_J: R518.1, U502.16
/Display_2/LED_K: R520.1, U502.15
/Display_2/LED_L: R514.1, U502.8
/Display_2/LED_M: R515.1, U502.6
/Display_2/LED_N: R517.1, U502.5
/Display_3/A0_SEL: R612.2, R613.1, U601.1
/Display_3/A1_SEL: R610.2, R611.1, U601.2
/Display_3/A2_SEL: R608.2, R609.1, U601.3
/Display_3/A3_SEL: R605.2, R606.1, U601.4
/Display_3/A4_SEL: R603.2, R604.1, U601.5
/Display_3/A5_SEL: R601.2, R602.1, U601.24
/Display_3/LED0: R623.2, U601.6
/Display_3/LED1: R614.2, U601.7
/Display_3/LED2: R624.2, U601.8
/Display_3/LED3: R615.2, U601.9
/Display_3/LED4: R617.2, U601.10
/Display_3/LED5: R626.2, U601.11
/Display_3/LED6: R616.2, U601.12
/Display_3/LED7: R625.2, U601.13
/Display_3/LED8: R628.2, U601.15
/Display_3/LED9: R619.2, U601.16
/Display_3/LED10: R627.2, U601.17
/Display_3/LED11: R618.2, U601.18
/Display_3/LED12: R620.2, U601.19
/Display_3/LED13: R629.2, U601.20
/Display_3/LED14: R621.2, U601.21
/Display_3/LED15: R630.2, U601.22
/Display_3/LED_A1: R627.1, U602.17
/Display_3/LED_A2: R629.1, U602.14
/Display_3/LED_B: R621.1, U602.13
/Display_3/LED_C: R623.1, U602.9
/Display_3/LED_D1: R626.1, U602.4
/Display_3/LED_D2: R624.1, U602.7
/Display_3/LED_DP0: R622.1, U602.10
/Display_3/LED_DP1: R631.1, U602.20
/Display_3/LED_E: R616.1, U602.3
/Display_3/LED_F: R628.1, U602.19
/Display_3/LED_G1: R625.1, U602.2
/Display_3/LED_G2: R630.1, U602.12
/Display_3/LED_H: R619.1, U602.18
/Display_3/LED_J: R618.1, U602.16
/Display_3/LED_K: R620.1, U602.15
/Display_3/LED_L: R614.1, U602.8
/Display_3/LED_M: R615.1, U602.6
/Display_3/LED_N: R617.1, U602.5
/Display_4/A0_SEL: R712.2, R713.1, U701.1
/Display_4/A1_SEL: R710.2, R711.1, U701.2
/Display_4/A2_SEL: R708.2, R709.1, U701.3
/Display_4/A3_SEL: R705.2, R706.1, U701.4
/Display_4/A4_SEL: R703.2, R704.1, U701.5
/Display_4/A5_SEL: R701.2, R702.1, U701.24
/Display_4/LED0: R723.2, U701.6
/Display_4/LED1: R714.2, U701.7
/Display_4/LED2: R724.2, U701.8
/Display_4/LED3: R715.2, U701.9
/Display_4/LED4: R717.2, U701.10
/Display_4/LED5: R726.2, U701.11
/Display_4/LED6: R716.2, U701.12
/Display_4/LED7: R725.2, U701.13
/Display_4/LED8: R728.2, U701.15
/Display_4/LED9: R719.2, U701.16
/Display_4/LED10: R727.2, U701.17
/Display_4/LED11: R718.2, U701.18
/Display_4/LED12: R720.2, U701.19
/Display_4/LED13: R729.2, U701.20
/Display_4/LED14: R721.2, U701.21
/Display_4/LED15: R730.2, U701.22
/Display_4/LED_A1: R727.1, U702.17
/Display_4/LED_A2: R729.1, U702.14
/Display_4/LED_B: R721.1, U702.13
/Display_4/LED_C: R723.1, U702.9
/Display_4/LED_D1: R726.1, U702.4
/Display_4/LED_D2: R724.1, U702.7
/Display_4/LED_DP0: R722.1, U702.10
/Display_4/LED_DP1: R731.1, U702.20
/Display_4/LED_E: R716.1, U702.3
/Display_4/LED_F: R728.1, U702.19
/Display_4/LED_G1: R725.1, U702.2
/Display_4/LED_G2: R730.1, U702.12
/Display_4/LED_H: R719.1, U702.18
/Display_4/LED_J: R718.1, U702.16
/Display_4/LED_K: R720.1, U702.15
/Display_4/LED_L: R714.1, U702.8
/Display_4/LED_M: R715.1, U702.6
/Display_4/LED_N: R717.1, U702.5
/EXT_CLK_DP: R124.2, R131.2, U201.25
/I2C_INT: J101.5, R1001.2, U102.2
/I2C_OE: J101.8, R111.2, R112.2, R113.2, R114.2, R115.2, R116.2, R117.2
/I2C_SCL: J101.7, R102.2, U102.1, U201.26, U301.26, U401.26, U501.26, U601.26, U701.26, U801.26
/I2C_SDA: J101.6, R103.2, U102.6, U201.27, U301.27, U401.27, U501.27, U601.27, U701.27, U801.27
/JACK_PRES: J102.3, R101.1, TP101.1
/LED_SPARE_1: TP104.1, U201.15
/LED_SPARE_2: TP105.1, U201.16
/LED_SPARE_3: TP106.1, U201.13
/LED_SPARE_4: TP107.1, U201.12
/OE_0: R111.1, R307.2, U301.23
/OE_1: R112.1, R407.2, U401.23
/OE_2: R113.1, R507.2, U501.23
/OE_3: R114.1, R607.2, U601.23
/OE_4: R115.1, R707.2, U701.23
/OE_5: R116.1, R807.2, U801.23
/OE_DP: R117.1, R207.2, U201.23
/V3P3_EN: R106.1, U101.7
/V3P3_LED: D102.1, R110.1
/V3P3_PG: R107.2, U101.4
/V3P3_SS: C103.1, U101.5
/V3P3_SW: C104.1, L101.1, U101.2
/V3P3_VBST: C104.2, U101.8
/V3P3_VFB: R108.2, R109.1, U101.6
/V6P0_JACK: J102.1, J103.5, J103.6
/V6P0_LED: D101.1, R105.1
/V6P0_RAW: C101.1, J103.3, J103.4, Q101.5, Q101.6, Q101.7, Q101.8
GND: C101.2, C102.2, C103.2, C105.2, C106.2, C107.2, C201.2, C202.2, C301.2, C302.2, C303.2, C401.2, C402.2, C403.2, C501.2, C502.2, C503.2, C601.2, C602.2, C603.2, C701.2, C702.2, C703.2, C801.2, C802.2, C803.2, H101.1, H102.1, H103.1, H104.1, J101.3, J101.4, J101.9, J102.2, R101.2, R104.1, R105.2, R109.2, R110.2, R118.1, R119.1, R120.1, R121.1, R122.1, R123.1, R124.1, R202.2, R204.2, R206.2, R209.2, R211.2, R213.2, R302.2, R304.2, R306.2, R309.2, R311.2, R313.2, R402.2, R404.2, R406.2, R409.2, R411.2, R413.2, R502.2, R504.2, R506.2, R509.2, R511.2, R513.2, R602.2, R604.2, R606.2, R609.2, R611.2, R613.2, R702.2, R704.2, R706.2, R709.2, R711.2, R713.2, R802.2, R804.2, R806.2, R809.2, R811.2, R813.2, U101.1, U102.3, U201.14, U301.14, U401.14, U501.14, U601.14, U701.14, U801.14
unnamed: Q101.4, R104.2
unnamed: R201.2, R202.1, U201.24
unnamed: R203.2, R204.1, U201.5
unnamed: R205.2, R206.1, U201.4
unnamed: R208.2, R209.1, U201.3
unnamed: R210.2, R211.1, U201.2
unnamed: R212.2, R213.1, U201.1
V3P3: C105.1, C106.1, C107.1, C201.1, C202.1, C301.1, C302.1, C401.1, C402.1, C501.1, C502.1, C601.1, C602.1, C701.1, C702.1, C801.1, C802.1, D102.2, L101.2, R102.1, R103.1, R107.1, R108.1, R201.1, R203.1, R205.1, R207.1, R208.1, R210.1, R212.1, R301.1, R303.1, R305.1, R307.1, R308.1, R310.1, R312.1, R401.1, R403.1, R405.1, R407.1, R408.1, R410.1, R412.1, R501.1, R503.1, R505.1, R507.1, R508.1, R510.1, R512.1, R601.1, R603.1, R605.1, R607.1, R608.1, R610.1, R612.1, R701.1, R703.1, R705.1, R707.1, R708.1, R710.1, R712.1, R801.1, R803.1, R805.1, R807.1, R808.1, R810.1, R812.1, R1001.1, TP103.1, U102.5, U201.28, U301.28, U401.28, U501.28, U601.28, U701.28, U801.28
V6P0: C102.1, C303.1, C403.1, C503.1, C603.1, C703.1, C803.1, D101.2, Q101.1, Q101.2, Q101.3, R106.2, TP102.1, U101.3, U302.1, U302.11, U402.1, U402.11, U502.1, U502.11, U602.1, U602.11, U702.1, U702.11, U802.1, U802.11
V6P0_SYSTEM: J101.1, J101.2, J103.1, J103.2
