ruralguru/ClockRadio_6x18SegDisp_I2C/(commit log)

2019-05-24 Package For Fab
    Rev 1.0.0
    [ClockRadio_6x18SegDisp_I2C.kicad_pcb, ClockRadio_6x18SegDisp_I2C.sch, DP_Driver.sch, Display.sch, I2C_6x18segDisp.ods]
2019-05-25 Commiting to the online
    [ClockRadio_6x18SegDisp_I2C.kicad_pcb]
2019-05-25 Updated Documentation Rev 1.0.0
    - Finished Critical Fabrication Dimensions.
    - Added Comments about Board.
    [ClockRadio_6x18SegDisp_I2C.kicad_pcb, ClockRadio_6x18SegDisp_I2C.ods, ClockRadio_6x18SegDisp_I2C.sch, DP_Driver.sch, Display.sch, I2C_6x18segDisp.ods]
2019-05-25 Cleanup
    File Organization
    [ClockRadio_6x18SegDisp_I2C.ods]
2019-05-25 Another Document Addition
    Added BOM to BOM's name
    [ClockRadio_6x18SegDisp_I2C_BOM.ods]
2019-07-02 Post assembly updates. Added pullup, R1001, for LUX sensor INT line. Changed R104 to 1k resolving issue.
    [ClockRadio_6x18SegDisp_I2C.kicad_pcb, ClockRadio_6x18SegDisp_I2C.sch, Display.sch, To Populate.ods]
2019-07-14 Schematic and Populated Components added.
    [ClockRadio_Populated.ods]
